Yeditepe-VLSI/IEEE_TTSKY26a_Miller_OTA/(commit log)

2026-05-06 fix project source file with new project name
    [project.v]
2026-05-06 pin edit
